Mukesh12mandal/AZRAEL-V1.0---Flight-Controller/(commit log)

2026-07-12 Initial commint: Core 6-DOF STM32 flight controller architecture
2026-09-23 Fix image syntax in Phase 1 section of README
    Updated image syntax for the breadboard prototype section in README.
